Pachaboo/Bryant-ZonePerfectPlus-ESP32/(commit log)

2026-09-23 Add files via upload
    Arduino sketch for ESP32.
2026-09-23 Rename ESP32 Wiring.jpeg to ESP32_Wiring.jpeg
2026-09-23 Rename Bryant Wiring.jpeg to Bryant_Wiring.jpeg
2026-09-23 Rename Finished Enclosure.jpeg to Finished_Enclosure.jpeg
2026-09-23 Rename Mounting Location.jpeg to Mounting_Location.jpeg
